PUT-Motorsport/PUTM_EV_TIRE_PRESSURE_INTERFACE/hardware/tire_pressure_interface.kicad_pcb

## KiCad design hardware/tire_pressure_interface.kicad_pcb (2026-10-11)

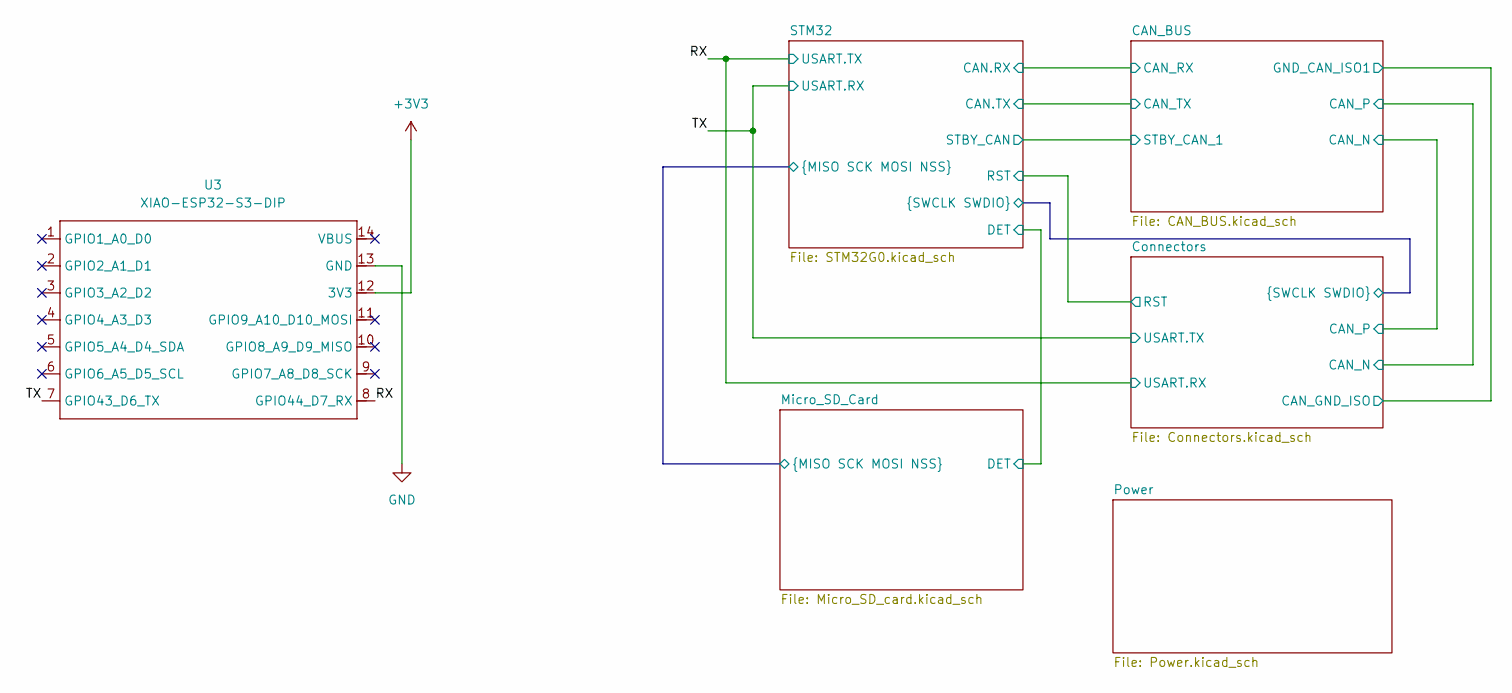
[picture p1: schematic tire_pressure_interface.kicad_sch]

Parts:
U3: XIAO-ESP32-S3-DIP

Connections:
+3V3: U3.12 (3V3); also elsewhere on the board
/RX: U3.8 (GPIO44_D7_RX); also elsewhere on the board
/TX: U3.7 (GPIO43_D6_TX); also elsewhere on the board
GND: U3.13 (GND); also elsewhere on the board

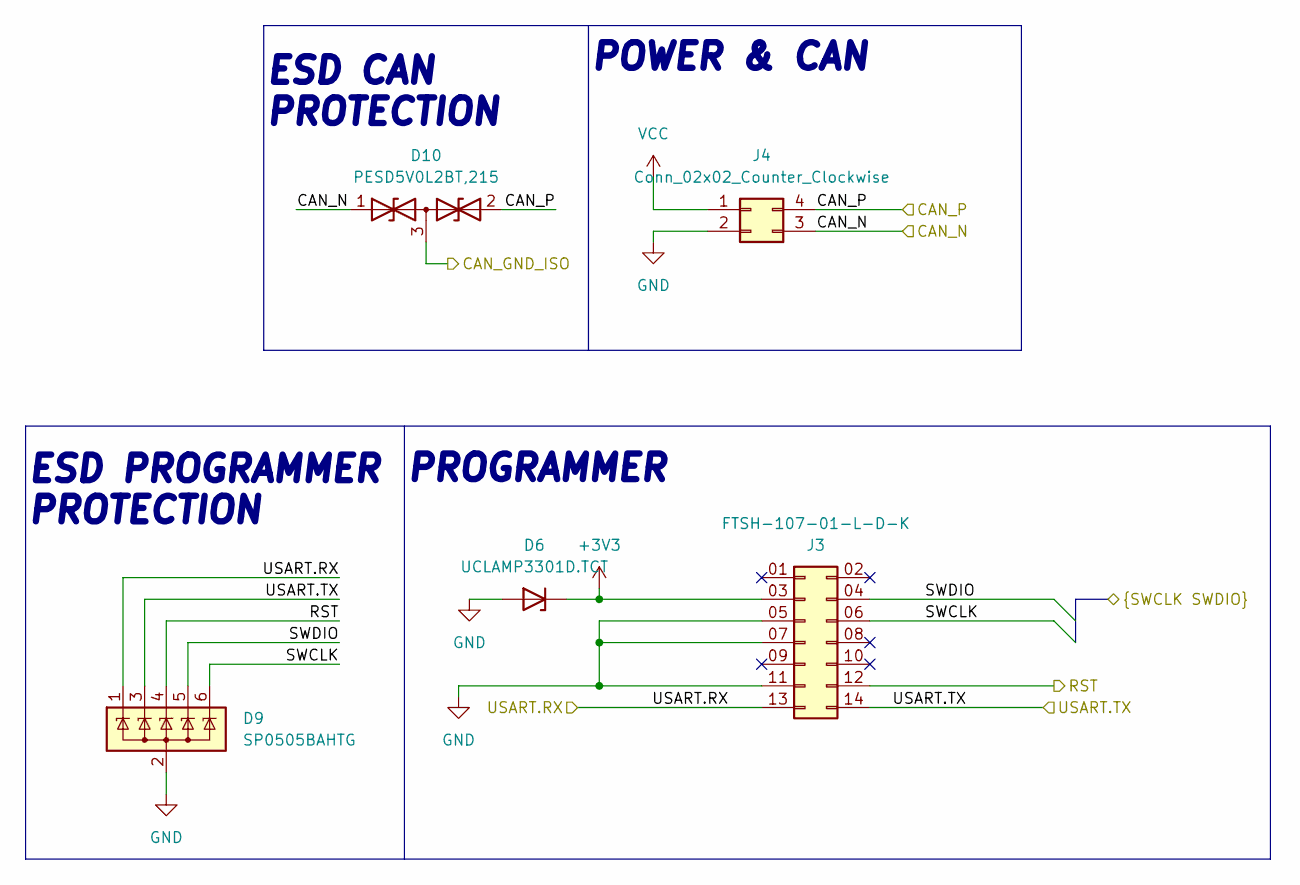
[picture p2: schematic Connectors.kicad_sch]

Parts:
D6: UCLAMP3301D.TCT; D_SOD-323_HandSoldering; Mouser number 947-UCLAMP3301D.TCT
D9: SP0505BAHTG; SOT-23-6_Handsoldering; Mouser Part Number 576-SP0505BAHTG
D10: PESD5V0L2BT,215; SOT-23-3; Mouser Part Number 771-PESD5V0S2BT-QR
J3: FTSH-107-01-L-D-K; SAMTEC_FTSH-107-01-L-D-K; Mouser Part Number 200-FTSH10701LDK
J4: Conn_02x02_Counter_Clockwise; JST_EH_S4B-EH_1x04_P2.50mm_Horizontal; Mouser part number 306-S4B-EHLFSN

Connections:
+3V3: D6.1 (K), J3.03 (Pin_3); also elsewhere on the board
/CAN_BUS/GND_CAN_ISO1: D10.3 (common); also elsewhere on the board
/Connectors/CAN_N: D10.1 (A1), J4.3; also elsewhere on the board
/Connectors/CAN_P: D10.2 (A2), J4.4; also elsewhere on the board
/Connectors/RST: D9.4 (K), J3.12; also elsewhere on the board
/Connectors/SWCLK: D9.6 (K), J3.06 (Pin_6); also elsewhere on the board
/Connectors/SWDIO: D9.5 (K), J3.04 (Pin_4); also elsewhere on the board
/RX: D9.1 (K), J3.13; also elsewhere on the board
/TX: D9.3 (K), J3.14; also elsewhere on the board
GND: D6.2 (A), D9.2 (A), J3.05 (Pin_5), J3.07 (Pin_7), J3.11, J4.2; also elsewhere on the board
VCC: J4.1; also elsewhere on the board

Notes on the sheet:
ESD PROGRAMMER PROTECTION
PROGRAMMER
POWER & CAN
ESD CAN PROTECTION

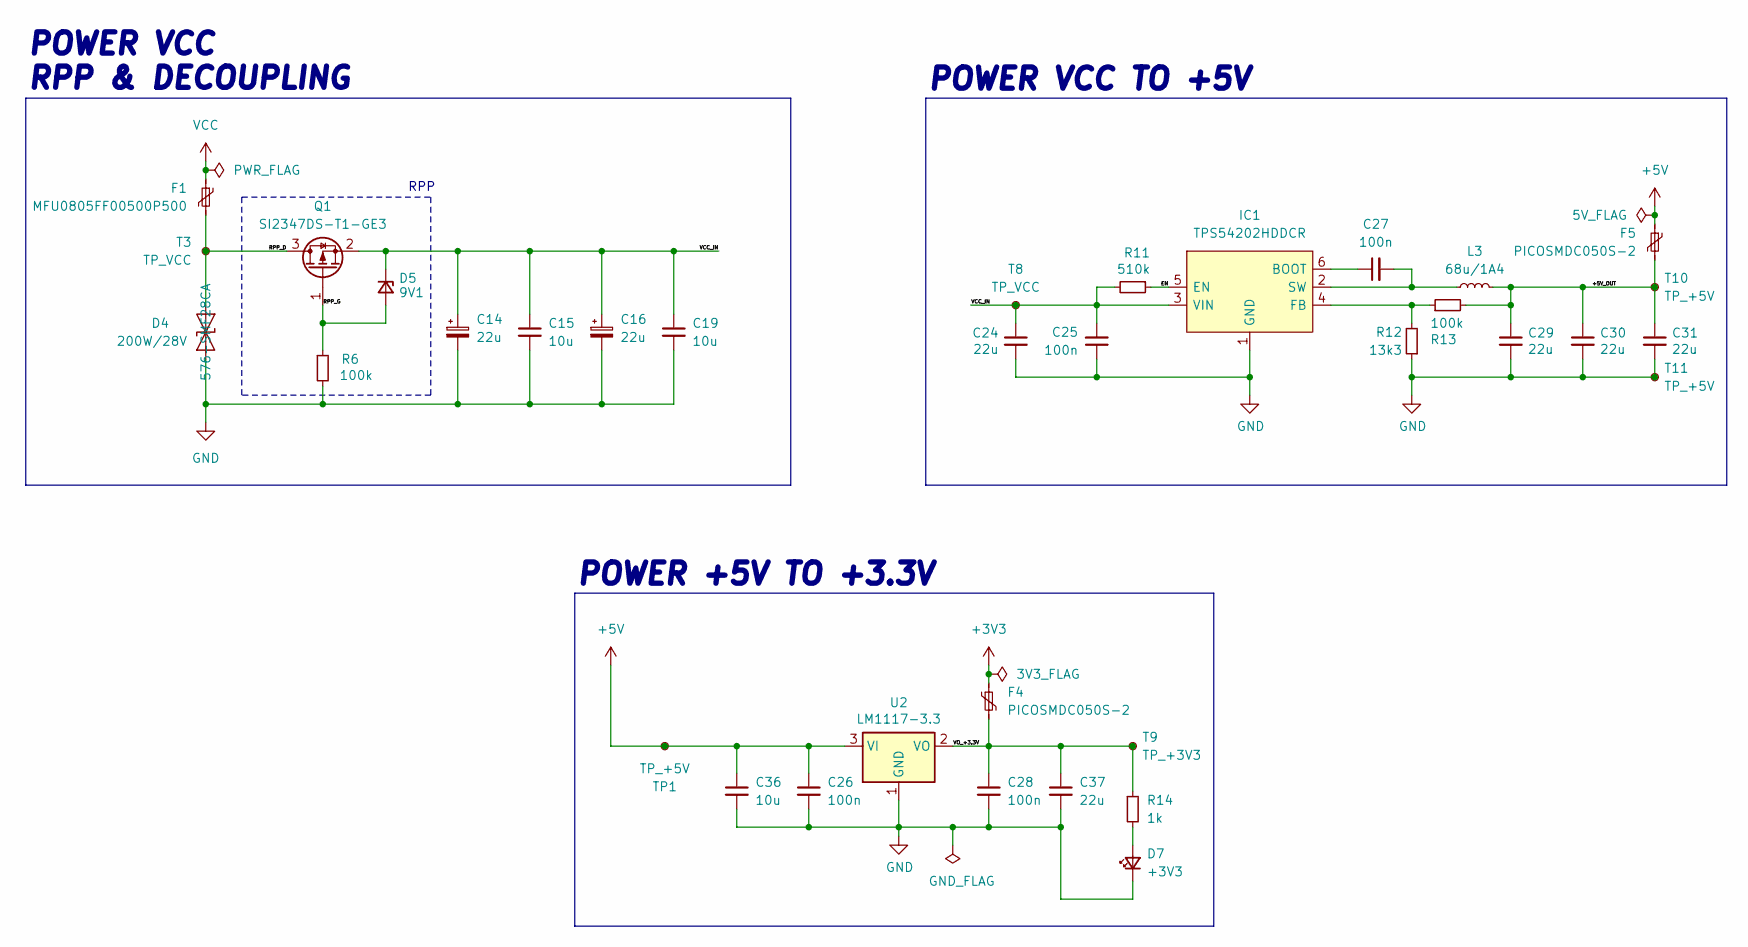
[picture p3: schematic Power.kicad_sch]

Parts:
C14, C16: 22u; CP_Elec_4x5.8; Mouser part number 647-UCM1V220MCL1GS
C15, C19: 10u; C_0805_2012Metric_Pad1.18x1.45mm_HandSolder; Mouser part number 810-C2012X5R1V106M0C
C24, C29, C30, C31: 22u; C_0805_2012Metric_Pad1.18x1.45mm_HandSolder; Manufacturer_Part_Number CL21A107MQYNNWE; Mouser Part Number 81-ZRA21CR61E226ME1L
C25, C27: 100n; C_0603_1608Metric_Pad1.08x0.95mm_HandSolder; Manufacturer_Part_Number MAJCU168BB7104KTEA01; Mouser Part Number 963-MAJCU168BB7104KT
C26, C28: 100n; C_0603_1608Metric_Pad1.08x0.95mm_HandSolder; Mouser part number 963-MAJCU168BB7104KT
C36: 10u; C_0603_1608Metric_Pad1.08x0.95mm_HandSolder; Mouser part number 187-CL10A106MA8NRWC
C37: 22u; C_0805_2012Metric_Pad1.18x1.45mm_HandSolder; Mouser part number 81-ZRA21CR61E226ME1L
D4: 200W/28V; D_SOD-123; Mouser part number 576-SMF28CA
D5: 9V1; D_SOD-323_HandSoldering; Mouser part number 863-SZMM3Z9V1T1G
D7: +3V3; LED_0603_1608Metric_Pad1.05x0.95mm_HandSolder
F1: MFU0805FF00500P500; Fuse_0805_2012Metric_Pad1.15x1.40mm_HandSolder; Mouser part number 594-MFU0805FF00500P1
F4, F5: PICOSMDC050S-2; Fuse_0805_2012Metric_Pad1.15x1.40mm_HandSolder
IC1: TPS54202HDDCR; SOT-23-6_Handsoldering; Mouser Part Number 595-TPS54202HDDCR
L3: 68u/1A4; L_TDK_VLS6045EX_VLS6045AF; Mouser Part Number 810-VLS6045EX-680M
Q1: SI2347DS-T1-GE3; SOT-23-3; Mouser part number 78-SI2347DS-T1-GE3
R6: 100k; R_0603_1608Metric_Pad0.98x0.95mm_HandSolder; Mouser part number 660-RK73B1JTTD104J
R11: 510k; R_0603_1608Metric_Pad0.98x0.95mm_HandSolder; Manufacturer_Part_Number RT0603DRD07510KL; Mouser Part Number 603-RT0603DRD07510KL
R12: 13k3; R_0603_1608Metric_Pad0.98x0.95mm_HandSolder; Manufacturer_Part_Number RT0603DRE0713K3L; Mouser Part Number 603-RT0603DRE0713K3L
R13: 100k; R_0603_1608Metric_Pad0.98x0.95mm_HandSolder; Manufacturer_Part_Number RT0603DRE07100KL; Mouser Part Number 603-RT0603DRE07100KL
R14: 1k; R_0603_1608Metric_Pad0.98x0.95mm_HandSolder
T3, T8: TP_VCC; TestPoint_Pad_1.0x1.0mm
T9: TP_+3V3; TestPoint_Pad_1.0x1.0mm
T10, T11: TP_+5V; TestPoint_Pad_1.0x1.0mm
TP1: TP_+5V; TestPoint_Pad_1.0x1.0mm
U2: LM1117-3.3; SOT-223-3_TabPin2

Connections:
+3V3: F4.1; also elsewhere on the board
+5V: C26.1, C36.1, F5.1, TP1.1 (1_1), U2.3 (VI); also elsewhere on the board
/Power/+5V_OUT: C29.1, C30.1, C31.1, F5.2, L3.2, R13.2, T10.1 (1_1)
/Power/EN: IC1.5 (EN), R11.1
/Power/RPP_D: D4.2 (A2), F1.2, Q1.3 (D), T3.1 (1_1)
/Power/RPP_G: D5.2 (A), Q1.1 (G), R6.1
/Power/VCC_IN: C14.1, C15.1, C16.1, C19.1, C24.1, C25.2, D5.1 (K), IC1.3 (VIN), Q1.2 (S), R11.2, T8.1 (1_1)
/Power/VO_+3.3V: C28.1, C37.1, F4.2, R14.1, T9.1 (1_1), U2.2 (VO)
GND: C14.2, C15.2, C16.2, C19.2, C24.2, C25.1, C26.2, C28.2, C29.2, C30.2, C31.2, C36.2, C37.2, D4.1 (A1), D7.1 (K), IC1.1 (GND), R6.2, R12.1, T11.1 (1_1), U2.1 (GND); also elsewhere on the board
unnamed: D7.2 (A), R14.2
unnamed: C27.1, IC1.6 (BOOT)
unnamed: IC1.4 (FB), R12.2, R13.1
unnamed: C27.2, IC1.2 (SW), L3.1
VCC: F1.1; also elsewhere on the board

Notes on the sheet:
POWER VCC TO +5V
POWER +5V TO +3.3V
POWER VCC RPP & DECOUPLING
RPP

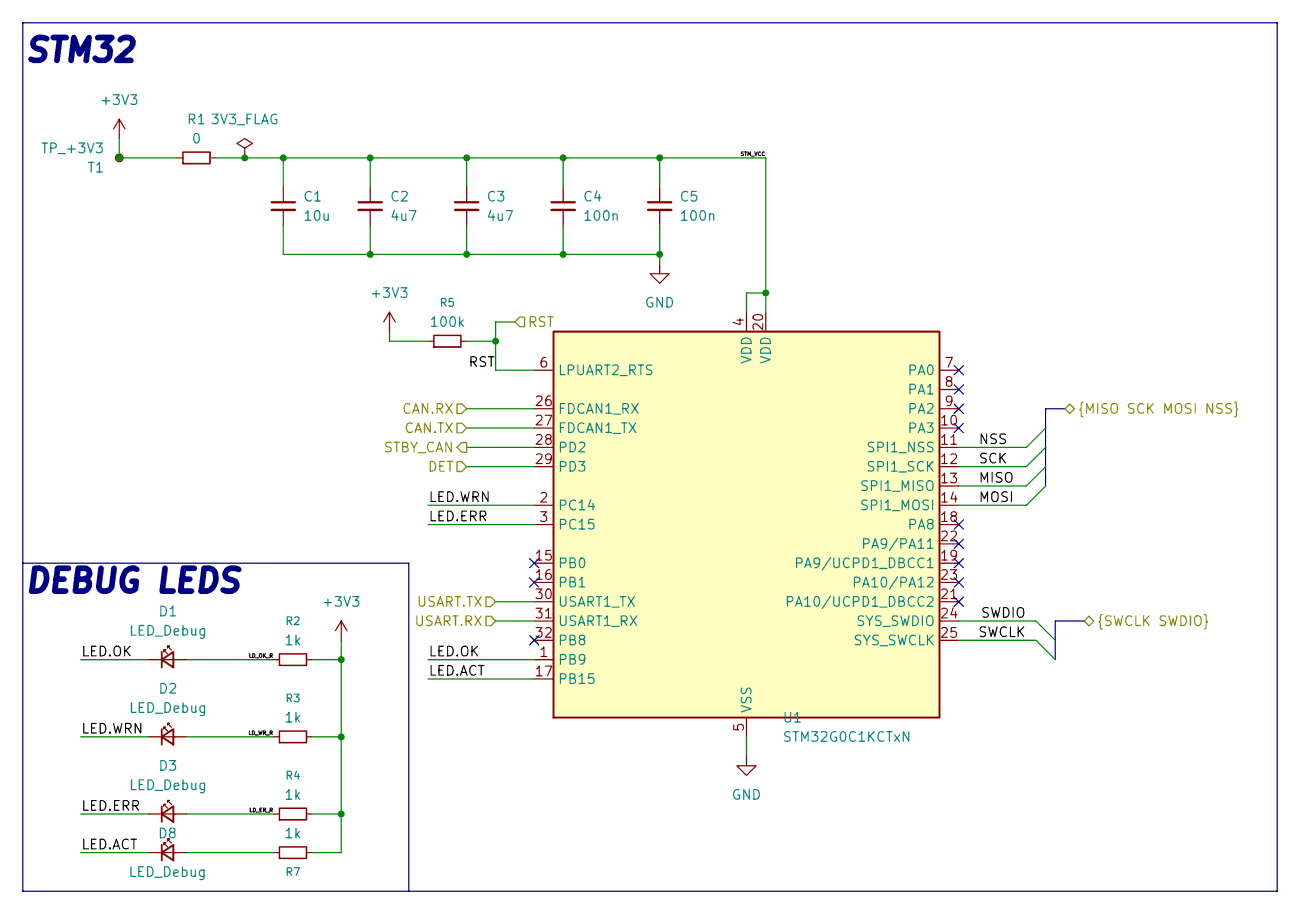
[picture p4: schematic STM32G0.kicad_sch]

Parts:
C1: 10u; C_0603_1608Metric_Pad1.08x0.95mm_HandSolder; Mouser Part Number 187-CL10A106MA8NRWC
C2, C3: 4u7; C_0603_1608Metric_Pad1.08x0.95mm_HandSolder; Mouser part number 810-C1608X5R1E475K
C4, C5: 100n; C_0603_1608Metric_Pad1.08x0.95mm_HandSolder; Mouser part number 963-MAJCU168BB7104KT
D1: LED_Debug; LED_0603_1608Metric_Pad1.05x0.95mm_HandSolder; Mouser part number 720-Q65113A7469
D2: LED_Debug; LED_0603_1608Metric_Pad1.05x0.95mm_HandSolder; Mouser part number 720-Q65113A5256
D3: LED_Debug; LED_0603_1608Metric_Pad1.05x0.95mm_HandSolder; Mouser part number 720-Q65113A7466
D8: LED_Debug; LED_0603_1608Metric_Pad1.05x0.95mm_HandSolder; Mouser part number 720-LYQ976.01
R1: 0; R_0603_1608Metric_Pad0.98x0.95mm_HandSolder; Mouser Part Number 71-CRCW06030000Z0ED
R2, R3, R4, R7: 1k; R_0603_1608Metric_Pad0.98x0.95mm_HandSolder; Mouser Part Number 71-CRCW06031K00FKED
R5: 100k; R_0603_1608Metric_Pad0.98x0.95mm_HandSolder; Mouser Part Number 603-RT0603DRE07100KL
T1: TP_+3V3; TestPoint_Pad_1.0x1.0mm
U1: STM32G0C1KCTxN; LQFP-32_7x7mm_P0.8mm; Mouser Part Number 511-STM32G0C1KCT6N

Connections:
+3V3: R1.1, R2.2, R3.2, R4.2, R5.1, R7.2, T1.1 (1_1); also elsewhere on the board
/CAN_BUS/CAN_RX: U1.26 (FDCAN1_RX); also elsewhere on the board
/CAN_BUS/CAN_TX: U1.27 (FDCAN1_TX); also elsewhere on the board
/CAN_BUS/STBY_CAN_1: U1.28 (PD2); also elsewhere on the board
/Connectors/RST: R5.2, U1.6 (LPUART2_RTS); also elsewhere on the board
/Connectors/SWCLK: U1.25 (SYS_SWCLK); also elsewhere on the board
/Connectors/SWDIO: U1.24 (SYS_SWDIO); also elsewhere on the board
/Micro_SD_Card/DET: U1.29 (PD3); also elsewhere on the board
/Micro_SD_Card/MISO: U1.13 (SPI1_MISO); also elsewhere on the board
/Micro_SD_Card/MOSI: U1.14 (SPI1_MOSI); also elsewhere on the board
/Micro_SD_Card/NSS: U1.11 (SPI1_NSS); also elsewhere on the board
/Micro_SD_Card/SCK: U1.12 (SPI1_SCK); also elsewhere on the board
/RX: U1.30 (USART1_TX); also elsewhere on the board
/STM32/LD_ER_R: D3.2 (A), R4.1
/STM32/LD_OK_R: D1.2 (A), R2.1
/STM32/LD_WR_R: D2.2 (A), R3.1
/STM32/LED.ACT: D8.1 (K), U1.17 (PB15)
/STM32/LED.ERR: D3.1 (K), U1.3 (PC15)
/STM32/LED.OK: D1.1 (K), U1.1 (PB9)
/STM32/LED.WRN: D2.1 (K), U1.2 (PC14)
/STM32/STM_VCC: C1.1, C2.1, C3.1, C4.1, C5.1, R1.2, U1.4 (VDD), U1.20 (VDD)
/TX: U1.31 (USART1_RX); also elsewhere on the board
GND: C1.2, C2.2, C3.2, C4.2, C5.2, U1.5 (VSS); also elsewhere on the board
unnamed: D8.2 (A), R7.1

Notes on the sheet:
DEBUG LEDS
STM32

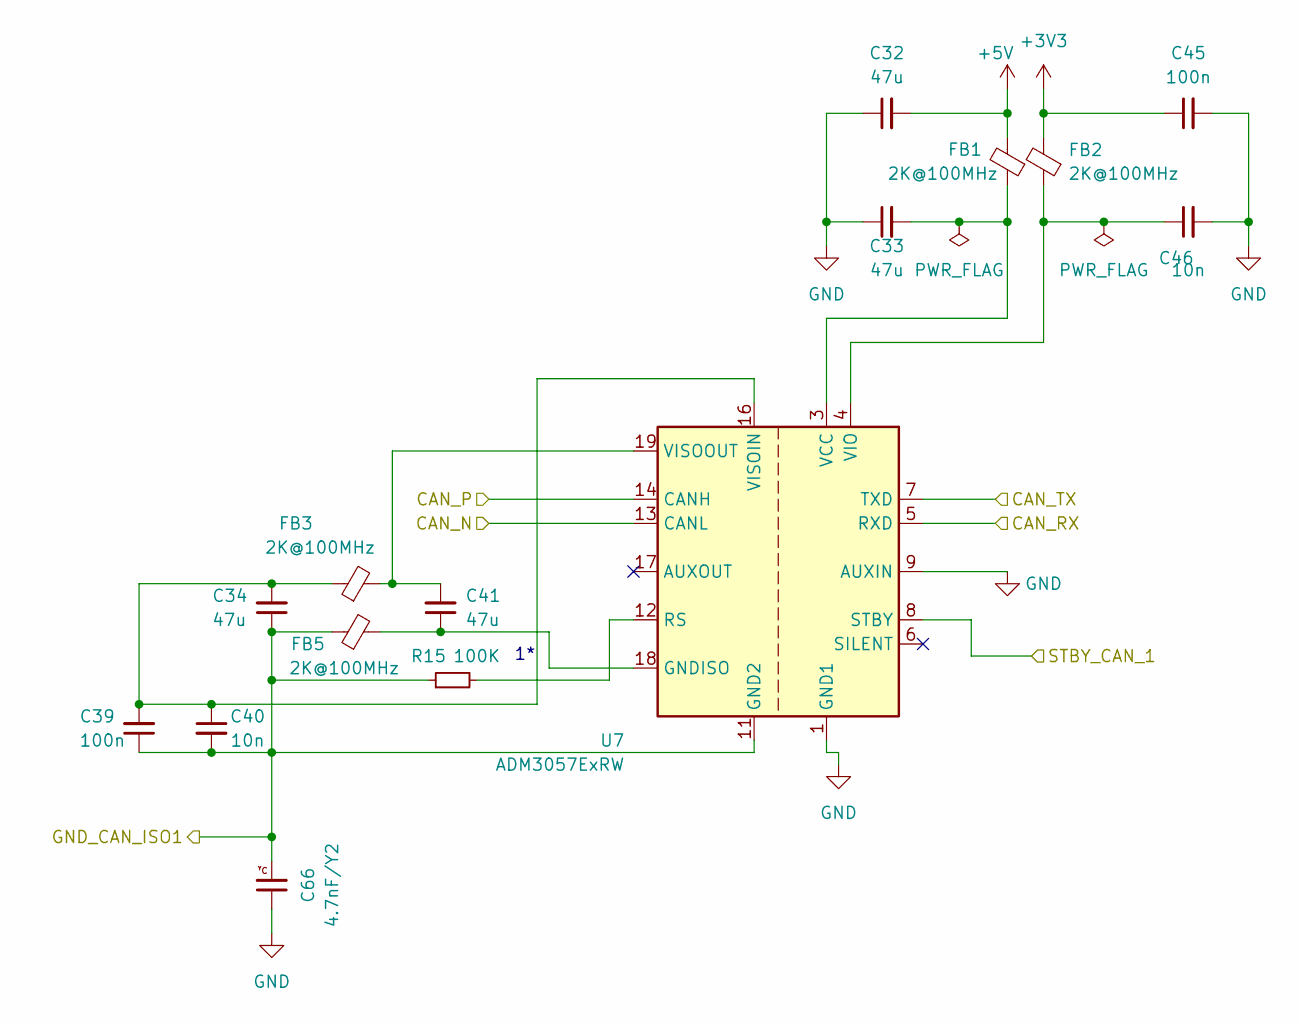
[picture p5: schematic CAN_BUS.kicad_sch]

Parts:
C32, C33, C34, C41: 47u; C_0805_2012Metric_Pad1.18x1.45mm_HandSolder; Mouser Part Number 81-GRM21BR60J476M01L
C39, C45: 100n; C_0603_1608Metric_Pad1.08x0.95mm_HandSolder; Mouser Part Number 963-MAJCU168BB7104KT
C40, C46: 10n; C_0603_1608Metric_Pad1.08x0.95mm_HandSolder; Mouser Part Number 81-GCJ188R71E103KA1D
C66: 4.7nF/Y2; CAPC5727X254N; Mouser Part Number 77-HV2225Y472KXVATHV
FB1, FB2, FB3, FB5: 2K@100MHz; L_0805_2012Metric_Pad1.05x1.20mm_HandSolder; Mouser Part Number 623-2508052027Y1
R15: 100K; R_0603_1608Metric_Pad0.98x0.95mm_HandSolder; Mouser Part Number 279-1-72225-5
U7: ADM3057ExRW; SOIC-20W_7.5x12.8mm_P1.27mm; Mouser Part Number 584-ADM3057EBRWZ

Connections:
+3V3: C45.1, FB2.2; also elsewhere on the board
+5V: C32.2, FB1.2; also elsewhere on the board
/CAN_BUS/CAN_RX: U7.5 (RXD); also elsewhere on the board
/CAN_BUS/CAN_TX: U7.7 (TXD); also elsewhere on the board
/CAN_BUS/GND_CAN_ISO1: C34.1, C39.1, C40.2, C66.2, FB5.1, R15.1, U7.11 (GND2), U7.15 (GND2); also elsewhere on the board
/CAN_BUS/STBY_CAN_1: U7.8 (STBY); also elsewhere on the board
/Connectors/CAN_N: U7.14 (CANH); also elsewhere on the board
/Connectors/CAN_P: U7.13 (CANL); also elsewhere on the board
GND: C32.1, C33.1, C45.2, C46.2, C66.1, U7.1 (GND1), U7.2 (GND1), U7.9 (AUXIN), U7.10 (GND1); also elsewhere on the board
unnamed: C41.1, FB5.2, U7.18 (GNDISO), U7.20 (GNDISO)
unnamed: R15.2, U7.12 (RS)
unnamed: C33.2, FB1.1, U7.3 (VCC)
unnamed: C46.1, FB2.1, U7.4 (VIO)
unnamed: C34.2, C39.2, C40.1, FB3.1, U7.16 (VISOIN)
unnamed: C41.2, FB3.2, U7.19 (VISOOUT)

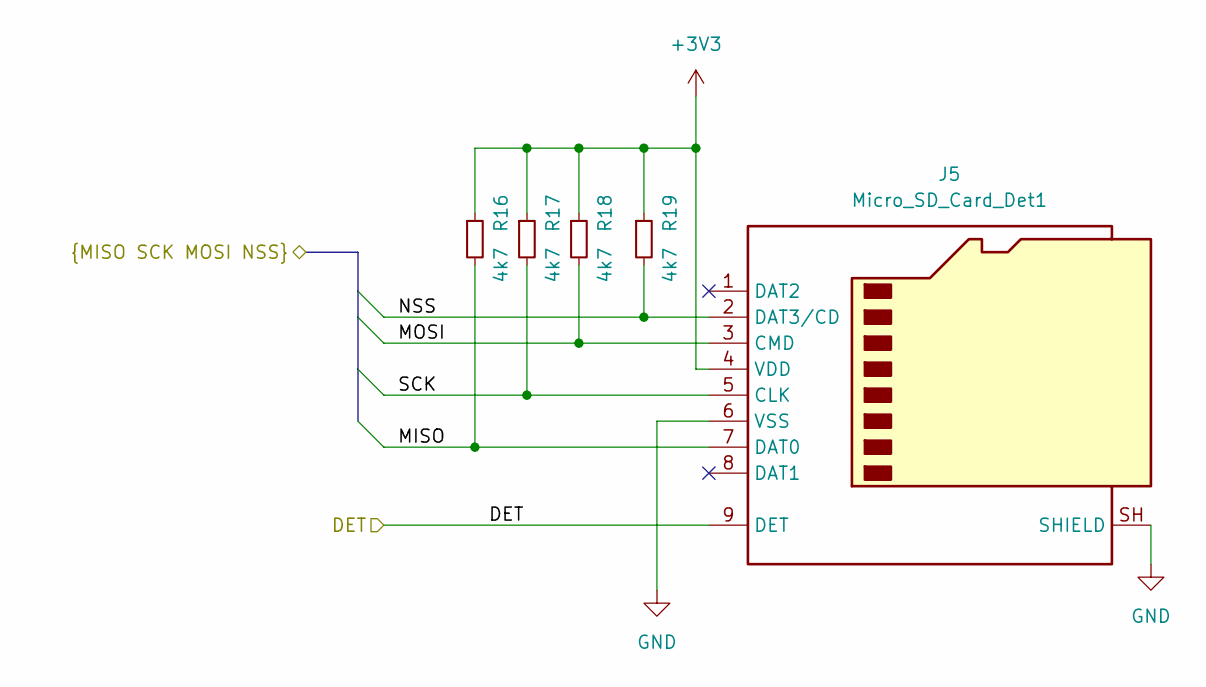
[picture p6: schematic Micro_SD_card.kicad_sch]

Parts:
J5: Micro_SD_Card_Det1; microSD_HC_Hirose_DM3AT-SF-PEJM5; Mouser part number 798-DM3AT-SF-PEJM5
R16, R17, R18, R19: 4k7; R_0603_1608Metric_Pad0.98x0.95mm_HandSolder; Mouser Part Number 71-CRCW0603-4.7K-E3

Connections:
+3V3: J5.4 (VDD), R16.1, R17.1, R18.1, R19.1; also elsewhere on the board
/Micro_SD_Card/DET: J5.9 (DET); also elsewhere on the board
/Micro_SD_Card/MISO: J5.7 (DAT0), R16.2; also elsewhere on the board
/Micro_SD_Card/MOSI: J5.3 (CMD), R18.2; also elsewhere on the board
/Micro_SD_Card/NSS: J5.2 (DAT3/CD), R19.2; also elsewhere on the board
/Micro_SD_Card/SCK: J5.5 (CLK), R17.2; also elsewhere on the board
GND: J5.6 (VSS), J5.SH (SHIELD); also elsewhere on the board

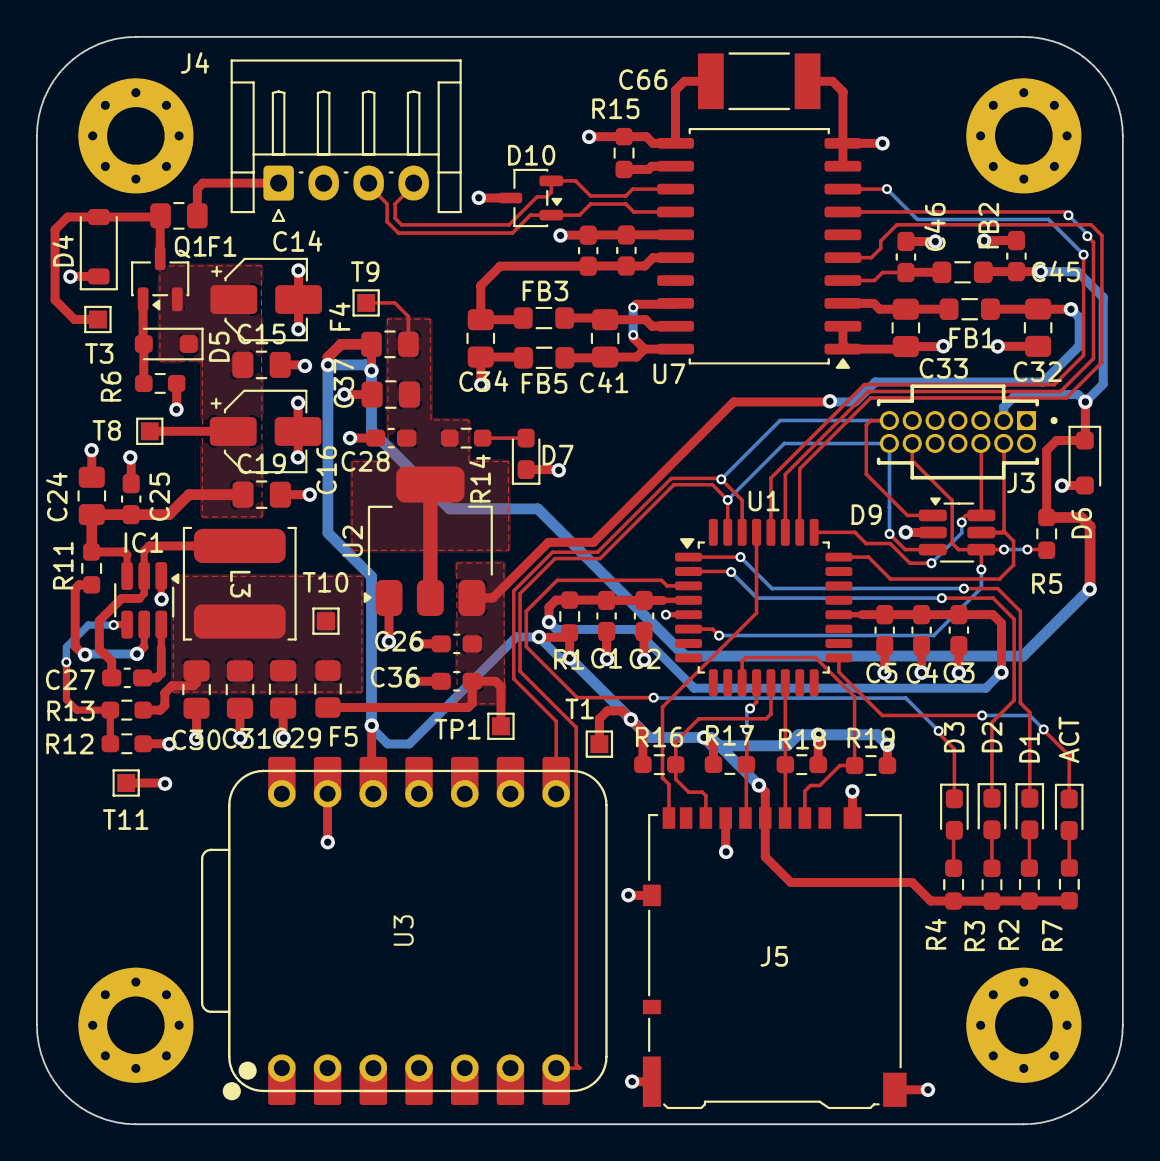
[picture p7: board tire_pressure_interface.kicad_pcb from above]

Board: 4 copper layers, 60.3 x 60.4 mm, 78 parts (0 on the bottom side), 45 nets.
