PUT-Motorsport/PUTM_EV_TIRE_PRESSURE_INTERFACE/(commit log)

2026-04-23 Initial commit: complete schematic
    [CAN_BUS.kicad_sch, Connectors.kicad_sch, Micro_SD_card.kicad_sch, Power.kicad_sch, STM32G0.kicad_sch, czujnik_temperatury_cisnienia.kicad_pcb, czujnik_temperatury_cisnienia.kicad_sch]
2026-04-24 reorganization of project folders acording to templates
    [CAN_BUS.kicad_sch, Connectors.kicad_sch, Micro_SD_card.kicad_sch, Power.kicad_sch, STM32G0.kicad_sch, czujnik_temperatury_cisnienia.kicad_pcb, tire_pressure_interface.kicad_pcb, tire_pressure_interface.kicad_sch]
2026-04-25 added missing files
    [CAN_BUS.kicad_sch, Micro_SD_card.kicad_sch, STM32G0.kicad_sch, tire_pressure_interface.kicad_sch]
2026-04-25 reorganize SPI signals into bus
    [Connectors.kicad_sch, Micro_SD_card.kicad_sch, STM32G0.kicad_sch, tire_pressure_interface.kicad_sch]
2026-05-01 initial component placement
    [CAN_BUS.kicad_sch, Connectors.kicad_sch, Micro_SD_card.kicad_sch, tire_pressure_interface.kicad_pcb]
2026-05-03 pcb routing
    [tire_pressure_interface.kicad_pcb]
2026-05-12 power section routing
    [tire_pressure_interface.kicad_pcb]
2026-05-25 power section and isocan layout
    [Power.kicad_sch, tire_pressure_interface.kicad_pcb]
2026-06-04 STM32G0 and micro sd layout
    [tire_pressure_interface.kicad_pcb]
2026-06-09 routing and PCB outline
    [tire_pressure_interface.kicad_pcb]
2026-06-16 changed layout
    [CAN_BUS.kicad_sch, Connectors.kicad_sch, tire_pressure_interface.kicad_pcb, tire_pressure_interface.kicad_sch]
2026-06-16 fixed drc issues
    [tire_pressure_interface.kicad_pcb]
2026-06-22 changed pcb layout
    [Micro_SD_card.kicad_sch, STM32G0.kicad_sch, tire_pressure_interface.kicad_pcb]
2026-06-25 fixed routing issues
    [STM32G0.kicad_sch, tire_pressure_interface.kicad_pcb]
2026-06-25 added missing TVS diode
    [Connectors.kicad_sch, tire_pressure_interface.kicad_pcb]
2026-06-25 added led description
    [tire_pressure_interface.kicad_pcb]
2026-06-25 removed 3v3 bcu fill
    [tire_pressure_interface.kicad_pcb]
2026-06-26 improved 3V3 routing
    [tire_pressure_interface.kicad_pcb]
2026-06-30 fixed 3v3 routing
    [tire_pressure_interface.kicad_pcb]
